joel-g/micro-electronics/dual-gauge/enclosure/README.md

# Dual-gauge enclosure

The [STL files and print guide](../../hardware/dual-gauge-enclosure/README.md)
are in the shared hardware directory. Both dual-display firmware projects use
the same enclosure.
