joel-g/micro-electronics/LICENSING.md

# Licensing scope

The repository's original source code, configuration files, build tools, tests
and technical documentation are licensed under the [MIT License](LICENSE),
unless a file explicitly identifies a different license. This applies across
the project subdirectories. Technical documentation includes README text,
wiring diagrams and generated gauge illustrations such as
`dual-gauge-can/docs/images/gauge-preview.png`.

MIT permits commercial use, modification and redistribution, including use in
assembled products and paid firmware offerings, subject to retaining its
copyright and license notice. It does not require sharing modifications.

## Photographs, videos and branding

Photographs, videos, logos and branding assets are excluded from the MIT grant
unless explicitly licensed otherwise. All rights in those assets are reserved
by their respective owners. In particular, the vehicle photograph at
`dual-gauge-can/docs/images/vehicle-gauges.png` is not MIT-licensed. Its appearance
in a README does not change its licensing status.

The software license does not grant a right to present a derivative product as
an official product or claim endorsement by the project author. Reuse of the
MIT-licensed code does not require purchasing hardware, support or updates.

## Third-party components

Dependencies and any third-party material retain their own licenses and notices;
the repository's MIT license does not replace them. This includes the Arduino
framework, ESP-IDF components and Adafruit libraries obtained by PlatformIO.
When distributing firmware or a built module, retain and comply with the
applicable dependency licenses as well as this project's MIT notice.
