joel-g/micro-electronics/hardware/dual-gauge-enclosure/front_v8_assembly.stl

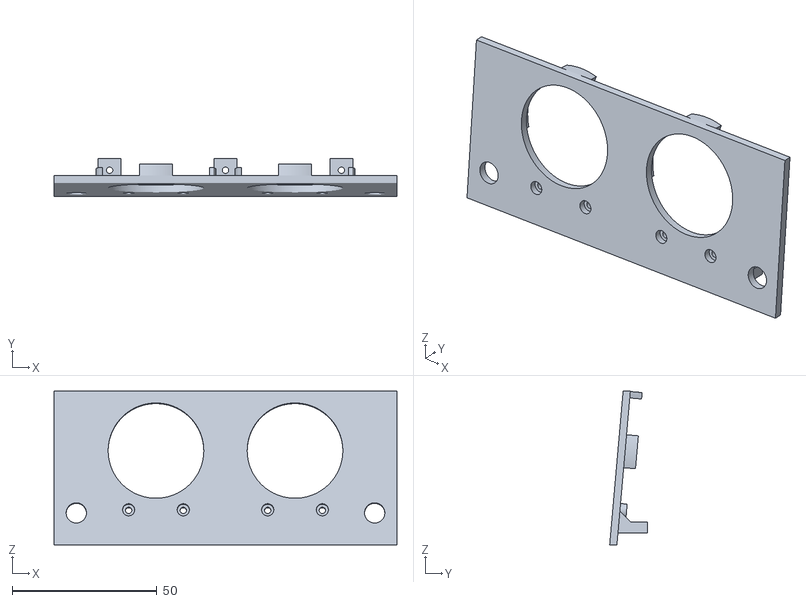
[picture p3: CAD file, 2026-11-11]
hardware/dual-gauge-enclosure/front_v8_assembly.stl
118.4 x 13.0 x 53.0
