joel-g/micro-electronics/hardware/dual-gauge-enclosure/floor_v8_assembly.stl

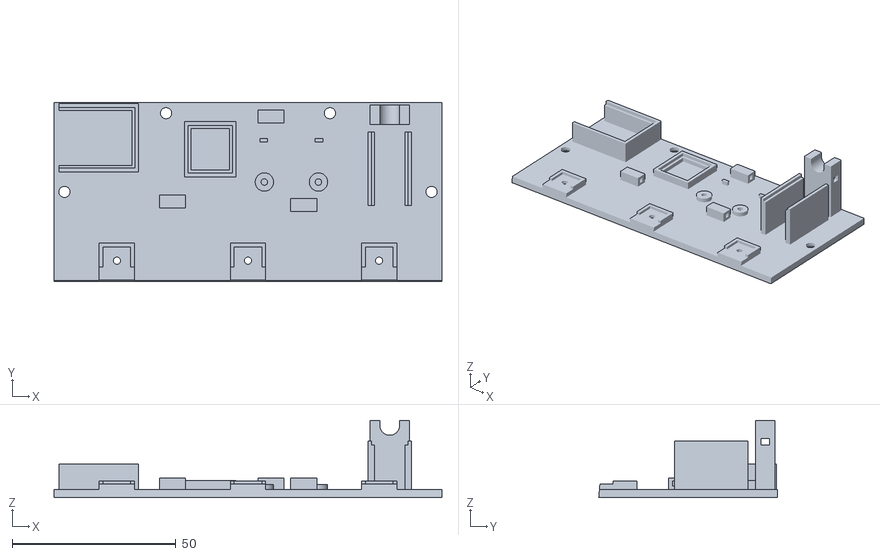
[picture p4: CAD file, 2026-11-11]
hardware/dual-gauge-enclosure/floor_v8_assembly.stl
118.4 x 54.5 x 23.5
