joel-g/micro-electronics/hardware/dual-gauge-enclosure/base_v7_fit_check.stl

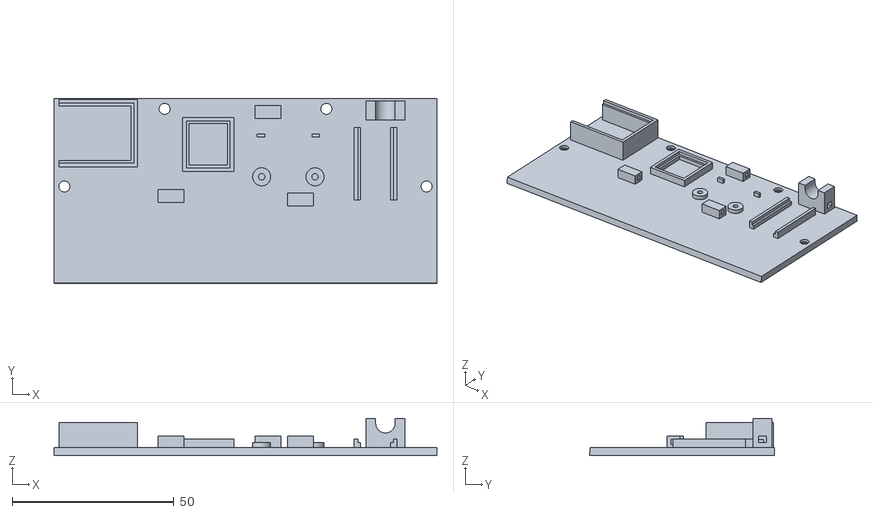
[picture p5: CAD file, 2026-11-11]
hardware/dual-gauge-enclosure/base_v7_fit_check.stl
118.4 x 57.2 x 11.5
