joel-g/micro-electronics/hardware/dual-gauge-enclosure/face_mount_fit_check_v2.stl

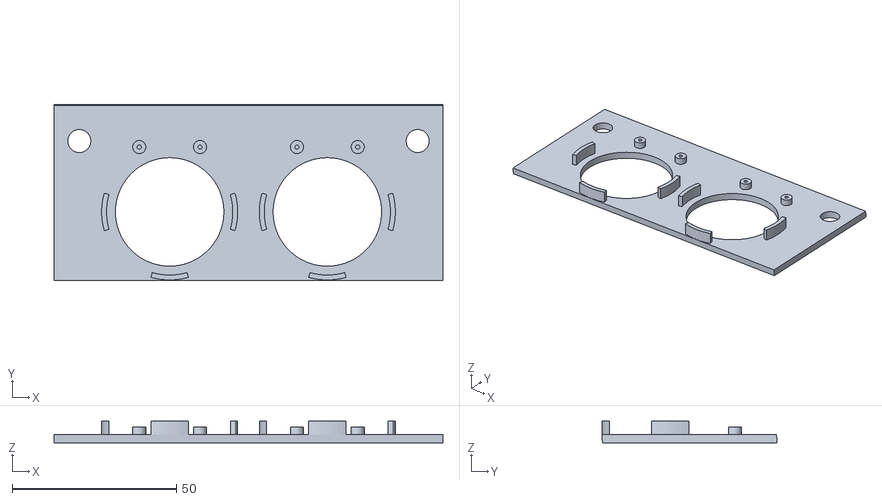
[picture p6: CAD file, 2026-11-11]
hardware/dual-gauge-enclosure/face_mount_fit_check_v2.stl
118.4 x 53.4 x 6.60
