joel-g/micro-electronics/hardware/dual-gauge-enclosure/cover_v8_print.stl

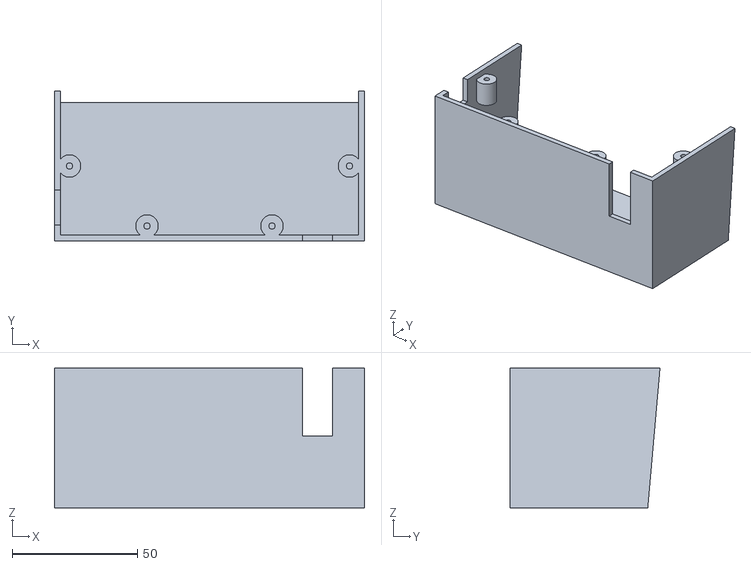
[picture p7: CAD file, 2026-11-11]
hardware/dual-gauge-enclosure/cover_v8_print.stl
124.0 x 60.0 x 55.8
