joel-g/micro-electronics/hardware/dual-gauge-enclosure/chassis_v7_m2.stl

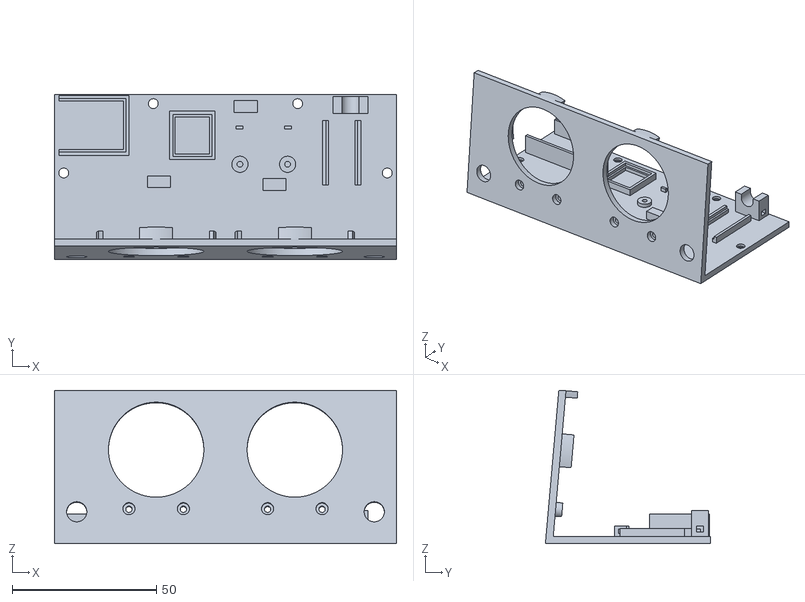
[picture p8: CAD file, 2026-11-11]
hardware/dual-gauge-enclosure/chassis_v7_m2.stl
118.4 x 57.2 x 53.0
