joel-g/micro-electronics/hardware/dual-gauge-enclosure/joint_front_v8_test.stl

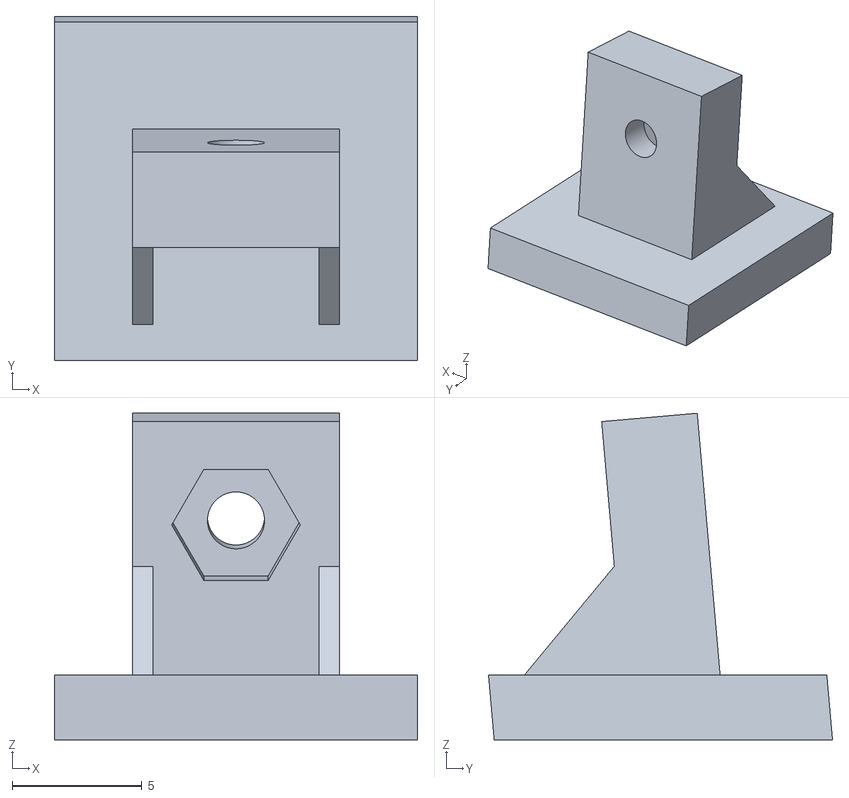
[picture p9: CAD file, 2026-11-11]
hardware/dual-gauge-enclosure/joint_front_v8_test.stl
14.0 x 13.3 x 12.6
