joel-g/micro-electronics/hardware/dual-gauge-enclosure/chassis_v4_pilot.stl

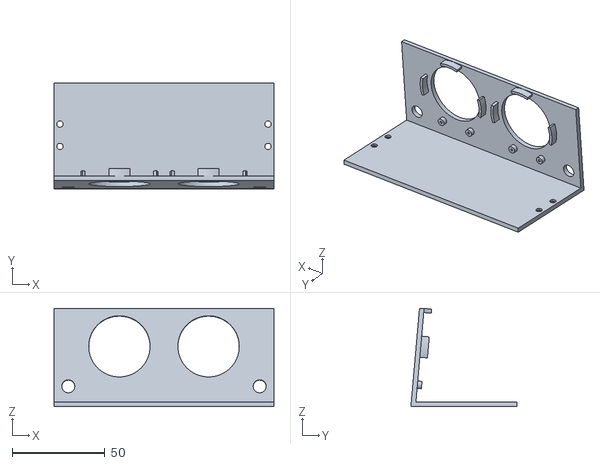
[picture p10: CAD file, 2026-11-11]
hardware/dual-gauge-enclosure/chassis_v4_pilot.stl
118.4 x 57.2 x 53.0
