joel-g/micro-electronics/hardware/dual-gauge-enclosure/joint_floor_v8_test.stl

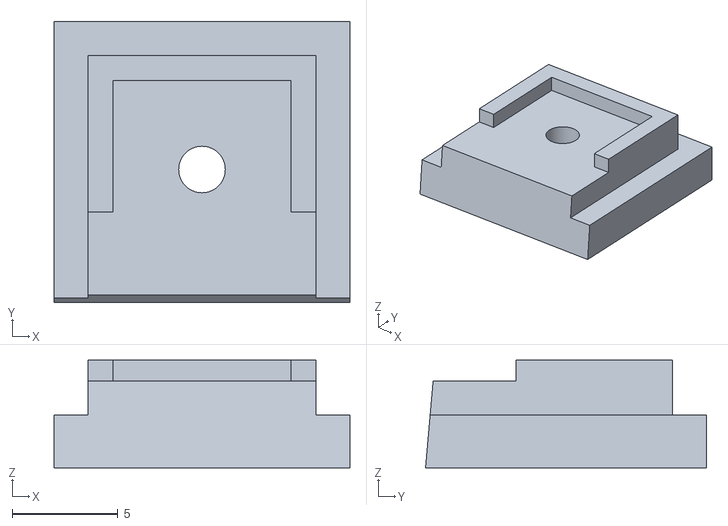
[picture p11: CAD file, 2026-11-11]
hardware/dual-gauge-enclosure/joint_floor_v8_test.stl
14.0 x 13.3 x 5.10
