joel-g/micro-electronics/(list of files, cad)

Other CAD files:
hardware/dual-gauge-enclosure/floor_v8_print.stl
hardware/dual-gauge-enclosure/front_v8_print.stl
hardware/dual-gauge-enclosure/face_mount_fit_check_v4_pilot.stl
hardware/dual-gauge-enclosure/cover_print.stl
hardware/dual-gauge-enclosure/cover_v7.stl
hardware/dual-gauge-enclosure/face_fit_check.stl
hardware/dual-gauge-enclosure/face_mount_fit_check_v7_m2.stl
hardware/dual-gauge-enclosure/chassis_v7_m2_face_down.stl
hardware/dual-gauge-enclosure/cover.stl
hardware/dual-gauge-enclosure/base_v5_fit_check.stl
hardware/dual-gauge-enclosure/base_v6_fit_check.stl
hardware/dual-gauge-enclosure/chassis_v3_m2.stl
hardware/dual-gauge-enclosure/chassis_v3_pilot.stl
hardware/dual-gauge-enclosure/chassis_v4_m2.stl
hardware/dual-gauge-enclosure/chassis_v5_m2.stl
hardware/dual-gauge-enclosure/chassis_v6_m2.stl
hardware/dual-gauge-enclosure/cover_v4.stl
hardware/dual-gauge-enclosure/cover_v4_print.stl
hardware/dual-gauge-enclosure/cover_v5.stl
hardware/dual-gauge-enclosure/cover_v5_print.stl
hardware/dual-gauge-enclosure/cover_v6.stl
hardware/dual-gauge-enclosure/cover_v6_print.stl
hardware/dual-gauge-enclosure/cover_v7_print.stl
hardware/dual-gauge-enclosure/face_mount_fit_check_v3_m2.stl
hardware/dual-gauge-enclosure/face_mount_fit_check_v3_pilot.stl
hardware/dual-gauge-enclosure/face_mount_fit_check_v4_m2.stl
hardware/dual-gauge-enclosure/face_mount_fit_check_v5_m2.stl
hardware/dual-gauge-enclosure/face_mount_fit_check_v6_m2.stl
