joel-g/micro-electronics/dual-gauge-can/include/hardware.h

#pragma once
#include <Arduino.h>

namespace hardware {
constexpr int sda = 1, scl = 2;
constexpr int sclk = 8, mosi = 9, horizonCs = 10, compassCs = 7, dc = 11, rst = 12;
constexpr int attitudeButton=13, compassButton=4;
constexpr int canTx=5, canRx=6; // TWAI listen-only; no application transmission.
constexpr int width = 240, height = 240;
constexpr uint32_t i2cHz = 400000;
constexpr uint16_t i2cTimeoutMs = 20;
#ifndef TFT_SPI_HZ
#define TFT_SPI_HZ 20000000
#endif
constexpr uint32_t spiHz = TFT_SPI_HZ;
}
