joel-g/micro-electronics/(commit log)

2026-10-30 Release standalone compass v1.0.0
    Add QMC5883P sensing, smooth compass rendering, hard-iron calibration with explicit NVS storage, bounded I/O and watchdog recovery. Include calibration instructions, a verification report, and BOMs for both instruments.
    Validation: PlatformIO release build and heading/calibration math tests pass. Hardware checks cover calibration persistence, heading response, sensor recovery, USB backpressure, and watchdog recovery. The user accepted v1 and reported more than 30 minutes of operation; the report distinguishes this manual observation from logged measurements.
2026-10-31 Release Compass & Horizon v1.0.0
    Combine the two existing instrument faces on one GC9A01 display with a debounced GPIO13 button and saved mode selection. Keep both sensors updating independently, reuse saved compass calibration, and preserve both standalone projects.
    Include a dedicated BOM, wiring and operating instructions, host tests, and a hardware verification report. Default/debug builds and button, compass math, geometry, repeated-switch, and saved-mode software-restart checks passed.
    User approved publication with recorded limitations: complete MPU-fault isolation, cold power-cycle mode persistence, extended soak, and combined-firmware watchdog injection remain unverified.
2026-10-31 Release Compass & Horizon v1.1.0
    Add two-second Horizon re-centering and Compass light/dark themes.
    Switch modes on short release and suppress switching after long holds.
    Document verified hardware behavior, release builds, and remaining limitations.
    [AttitudeGauge.cpp, CompassGauge.cpp, Display.cpp, attitude_gauge.h, button.h, button_action.h]
2026-10-31 Render Compass & Horizon wiring diagram with Mermaid
2026-11-06 Release Dual Gauge with Buttons v1.0.0
    Add independent dual-screen controls, persisted compass themes and numerical
    attitude mode, long-press level setting, and validated 60-second calibration
    with automatic save. Include wiring, BOM, native tests, and hardware results.
2026-11-08 Release Dual Gauge CAN v1.0.0
    Add the independent dual-display Link Generic Dash project with JSON configuration, per-screen face manifests, color-coded engine gauges, BOM, wiring documentation and a vehicle photo.
    Record automated and vehicle validation separately: the final configuration revision is built and host-tested, with flashing and hardware confirmation deferred.
2026-11-11 Add enclosure STL revisions and printing guide
    [base_v5_fit_check.stl, base_v6_fit_check.stl, base_v7_fit_check.stl, chassis.stl, chassis_v3_m2.stl, chassis_v3_pilot.stl, chassis_v4_m2.stl, chassis_v4_pilot.stl]
2026-11-11 Share indexed framebuffer across gauge firmware
2026-11-11 Move shared dual-gauge enclosure into hardware
    [base_v5_fit_check.stl, base_v6_fit_check.stl, base_v7_fit_check.stl, chassis.stl, chassis_v3_m2.stl, chassis_v3_pilot.stl, chassis_v4_m2.stl, chassis_v4_pilot.stl]
